MakeMagazinDE/Lora-Tuerueberwachung/Arduino_IDE_Boardeintrag ESP32-Board.png

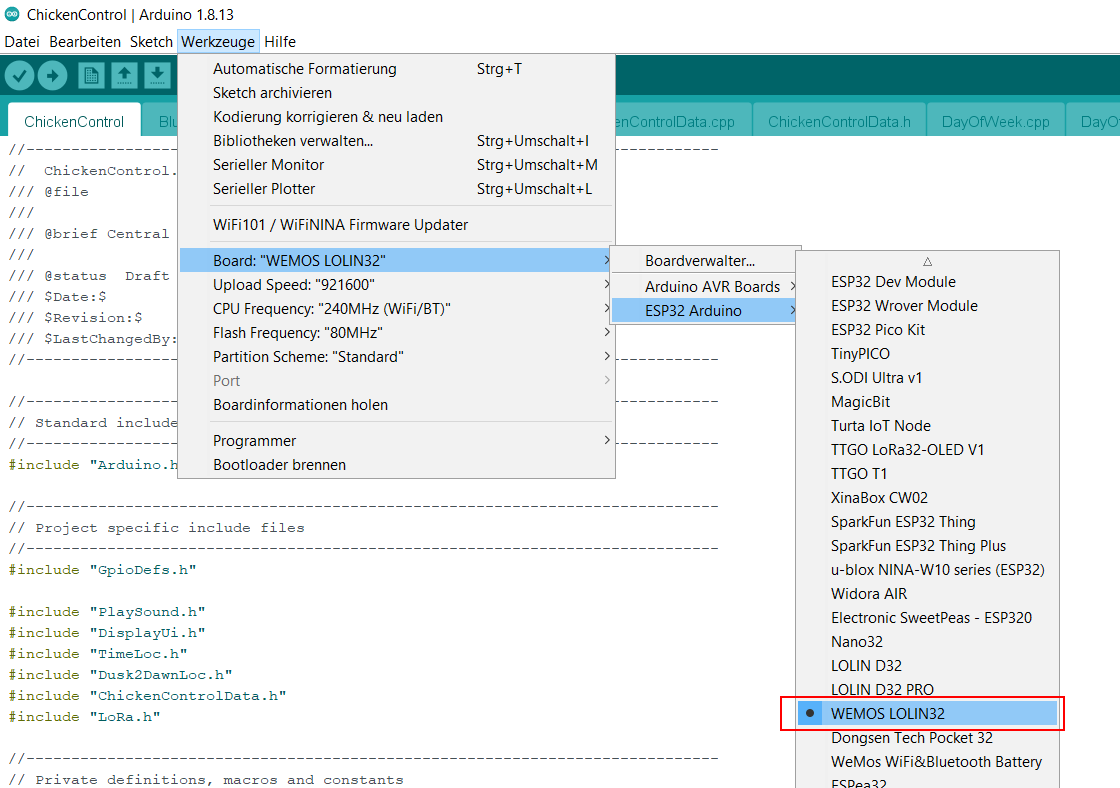
Arduino_IDE_Boardeintrag ESP32-Board.png
