MakeMagazinDE/Lora-Tuerueberwachung/Arduino_IDE_Library_Manager.png

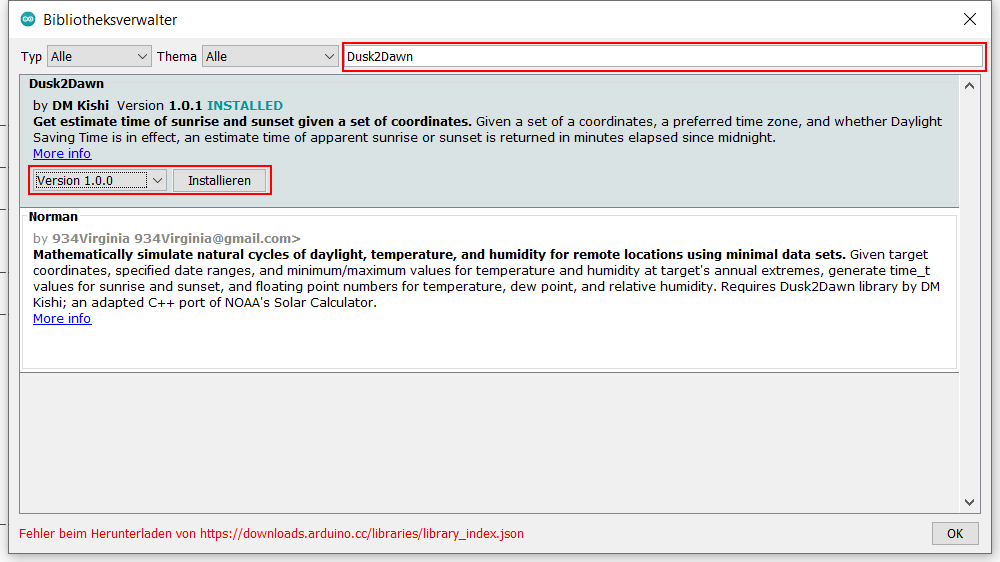
Arduino_IDE_Library_Manager.png
