MakeMagazinDE/Lora-Tuerueberwachung/Befestigung Ampmodul.png

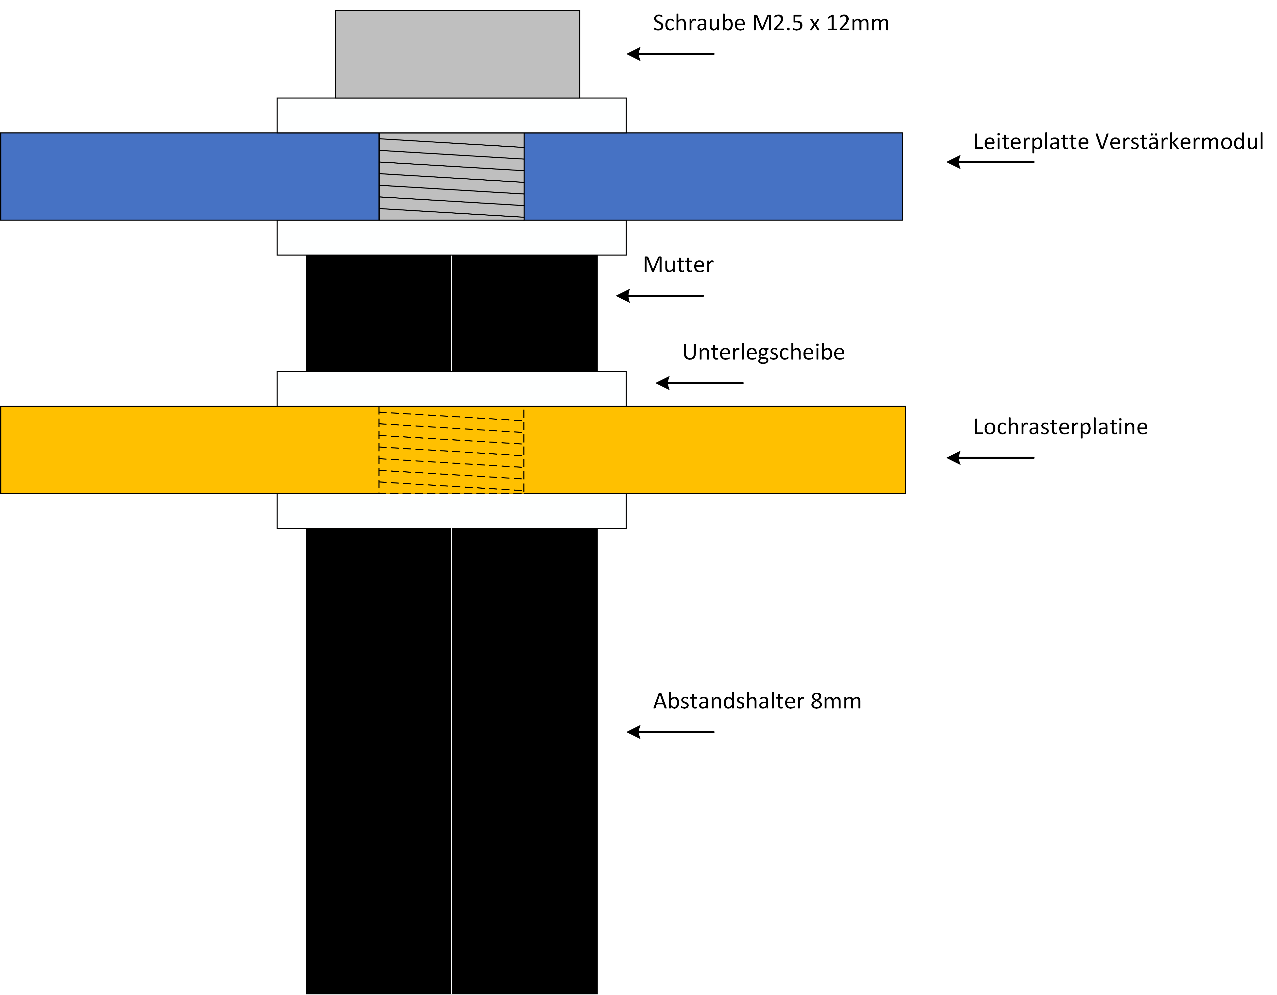
Befestigung Ampmodul.png
