MakeMagazinDE/Lora-Tuerueberwachung/ChickenControl Taskmodell.png

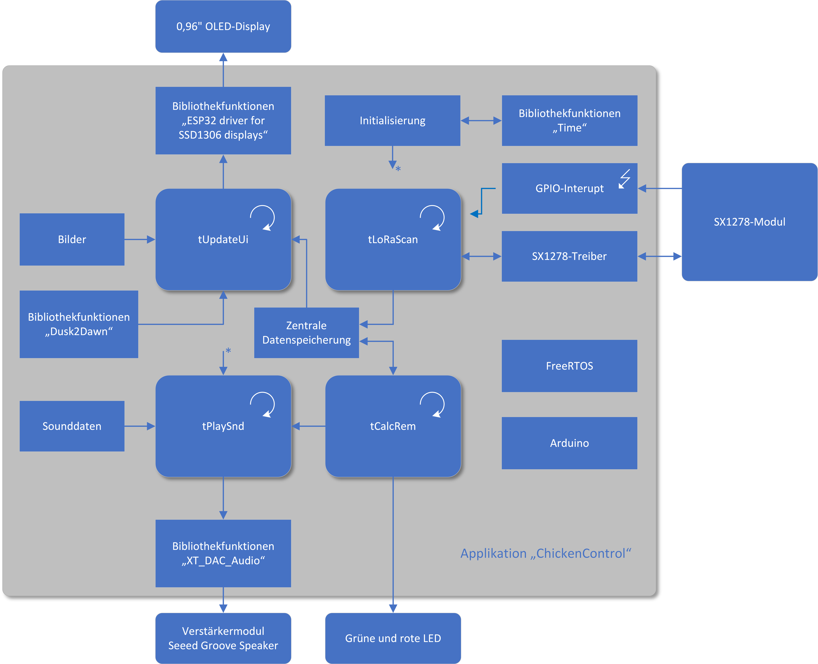
ChickenControl Taskmodell.png
