MakeMagazinDE/Lora-Tuerueberwachung/ChickenControl/DSCF0216_217_Combi.JPG

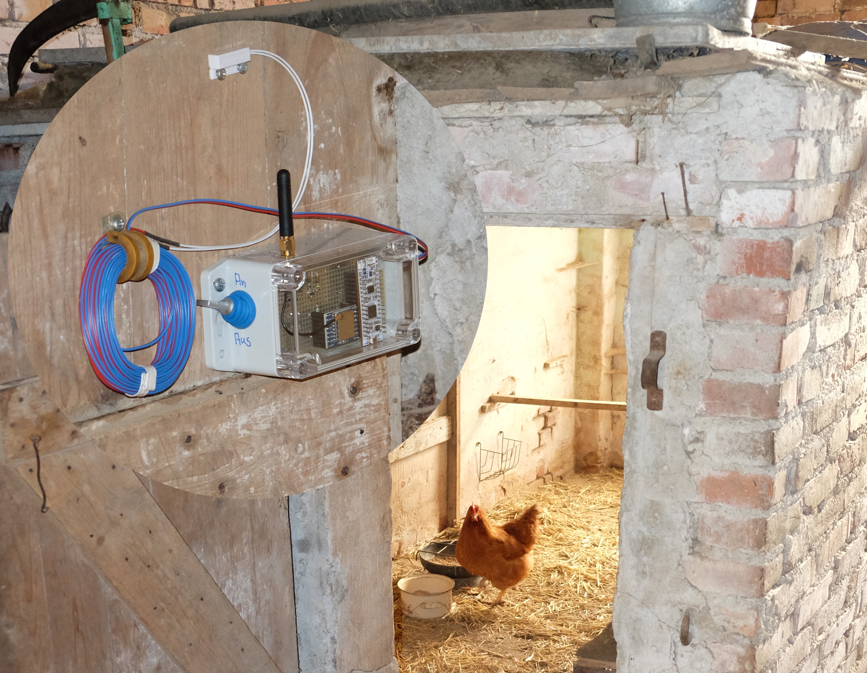
ChickenControl/DSCF0216_217_Combi.JPG
