MakeMagazinDE/Lora-Tuerueberwachung/ChickenControl_Ansicht_Oberseite.png

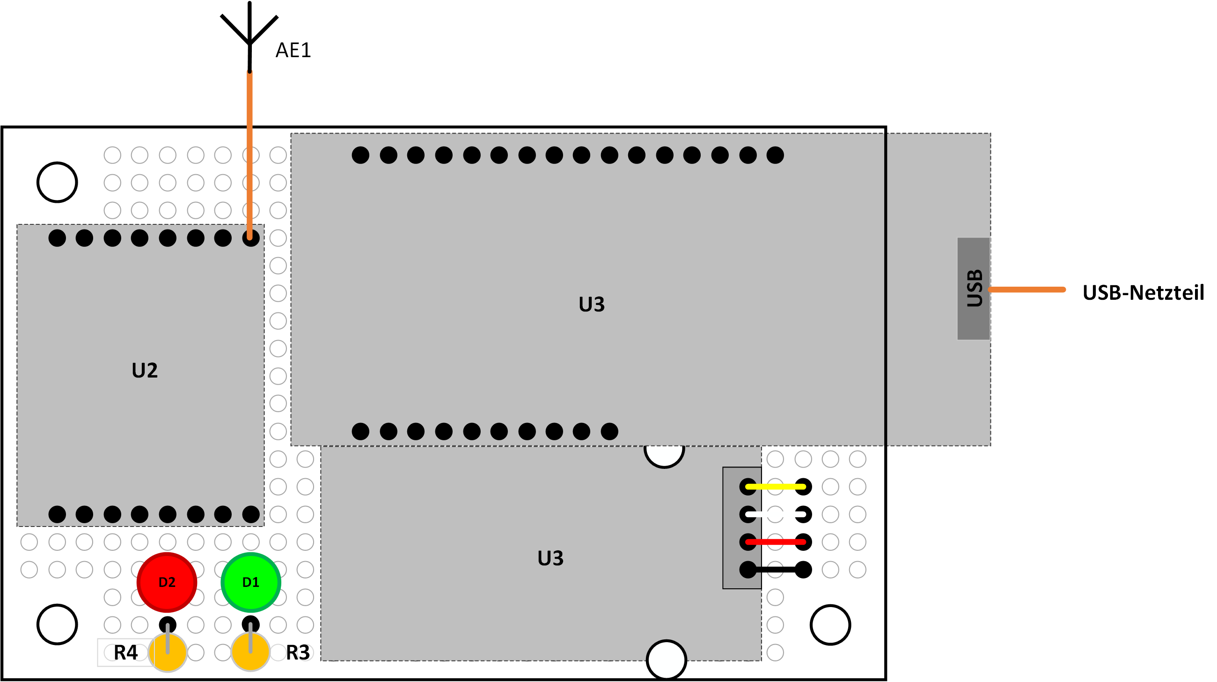
ChickenControl_Ansicht_Oberseite.png
