MakeMagazinDE/Lora-Tuerueberwachung/ChickenControl_Verdrahtung_einseitig.png

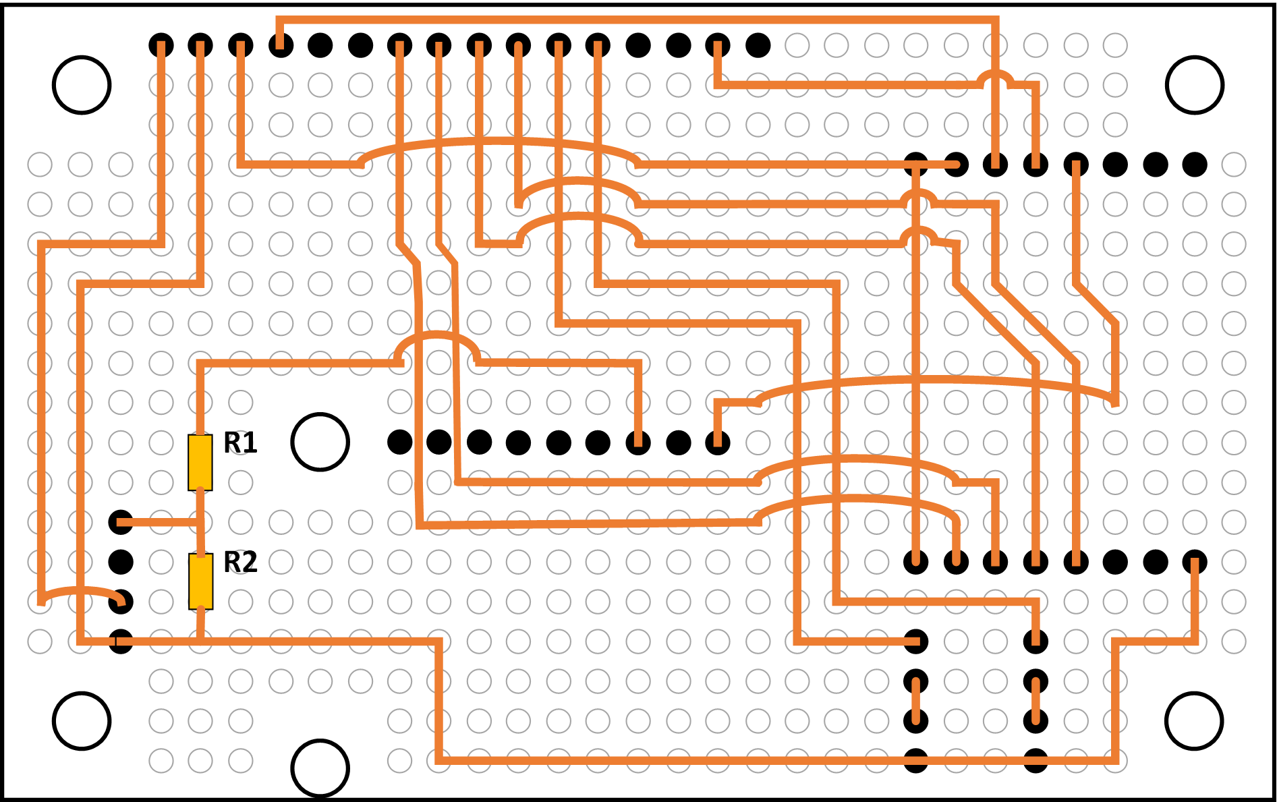
ChickenControl_Verdrahtung_einseitig.png
