MakeMagazinDE/Lora-Tuerueberwachung/ChickenControl_Verdrahtung_zweiseitig.png

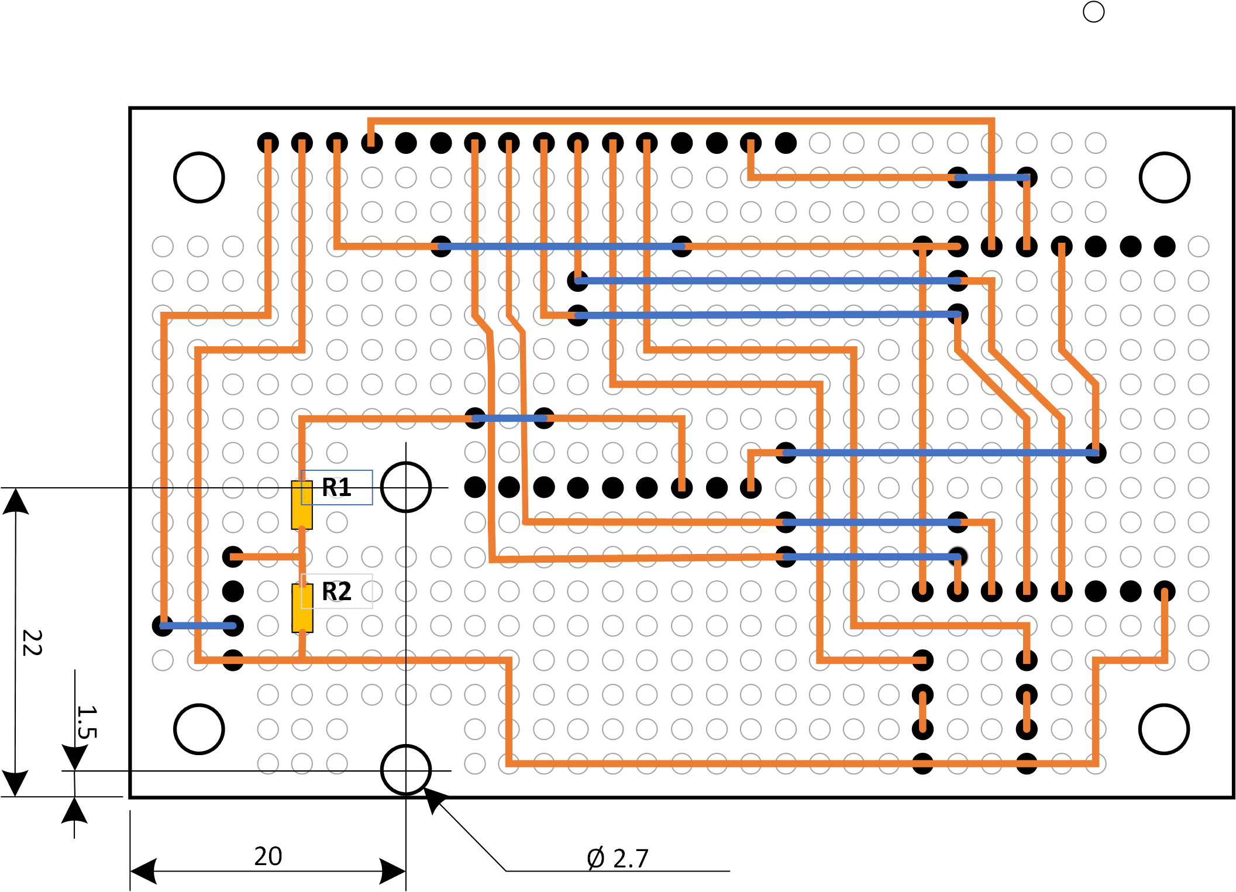
ChickenControl_Verdrahtung_zweiseitig.png
