MakeMagazinDE/Lora-Tuerueberwachung/ChickenHouse Ablaufplan.png

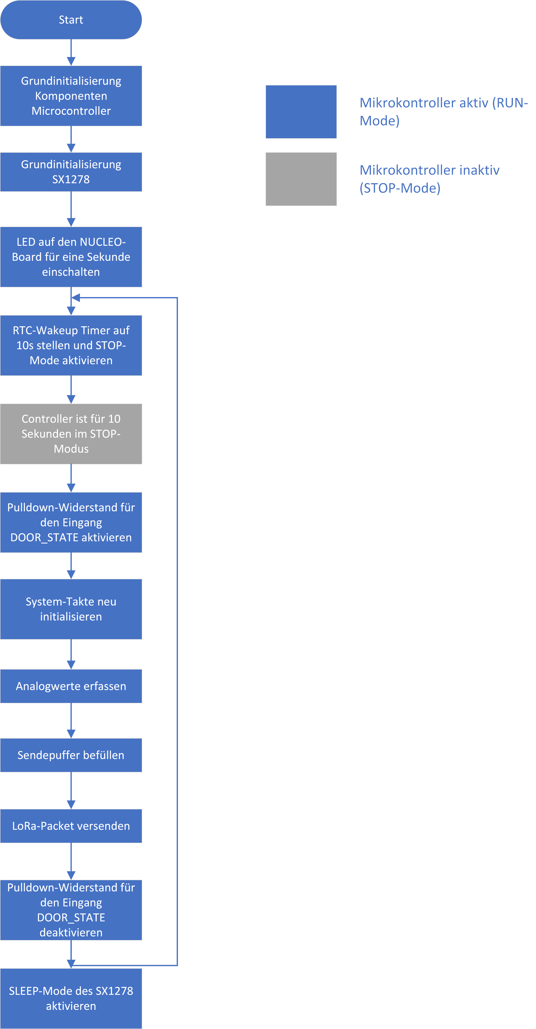
ChickenHouse Ablaufplan.png
