MakeMagazinDE/Lora-Tuerueberwachung/ChickenHouse_Leiterplatte_Oberseite_Alternativ.png

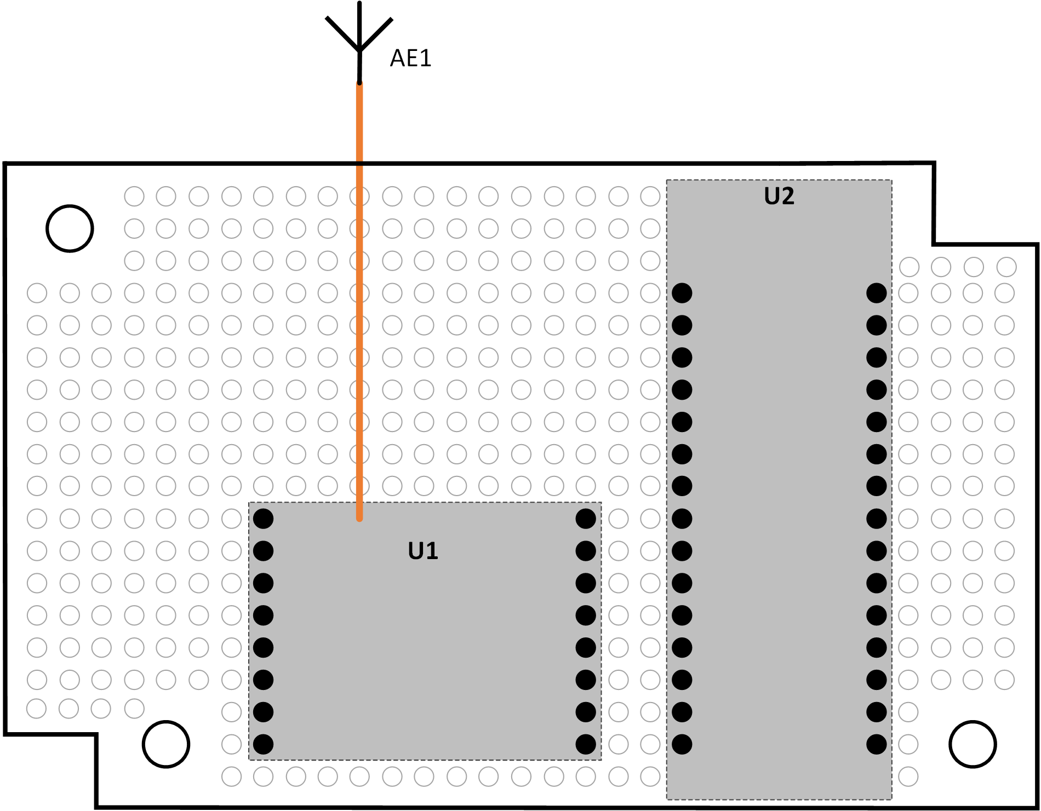
ChickenHouse_Leiterplatte_Oberseite_Alternativ.png
