MakeMagazinDE/Lora-Tuerueberwachung/ChickenHouse_Leiterplatte_Oberseite_fuellend.png

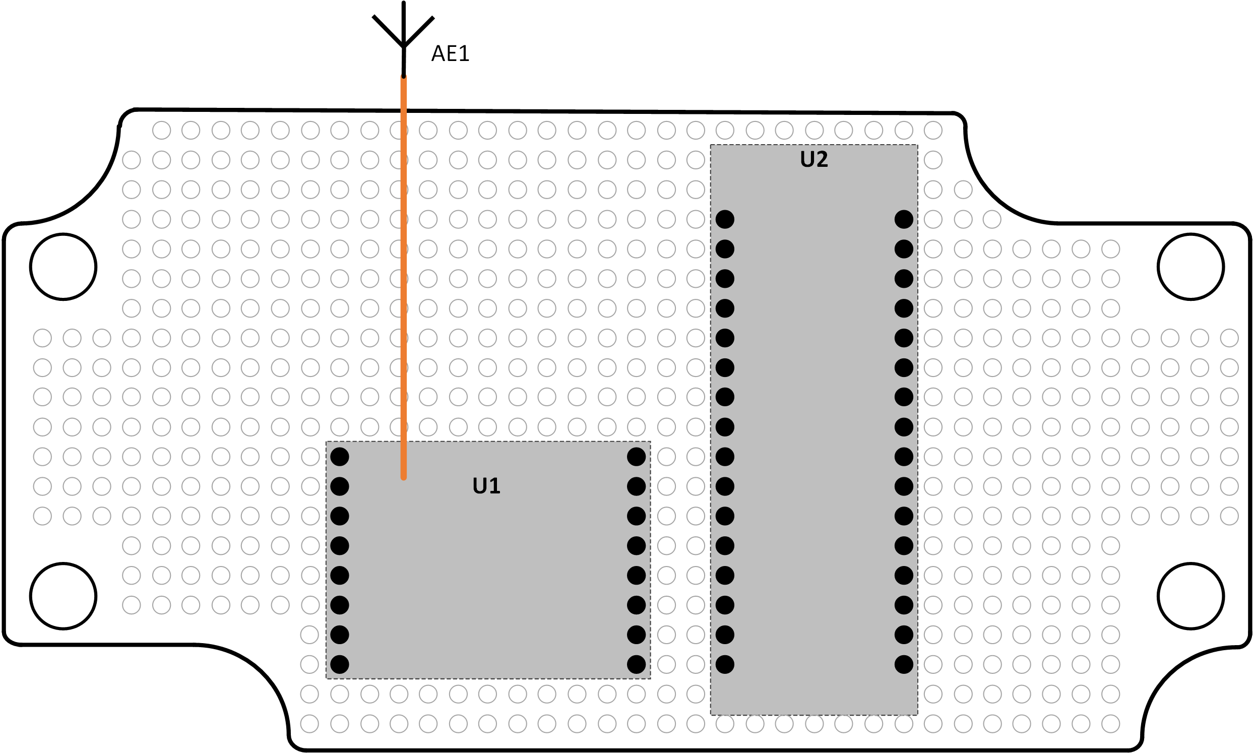
ChickenHouse_Leiterplatte_Oberseite_fuellend.png
