MakeMagazinDE/Lora-Tuerueberwachung/ChickenHouse_Leiterplatte_Unterseite_Alternativ.png

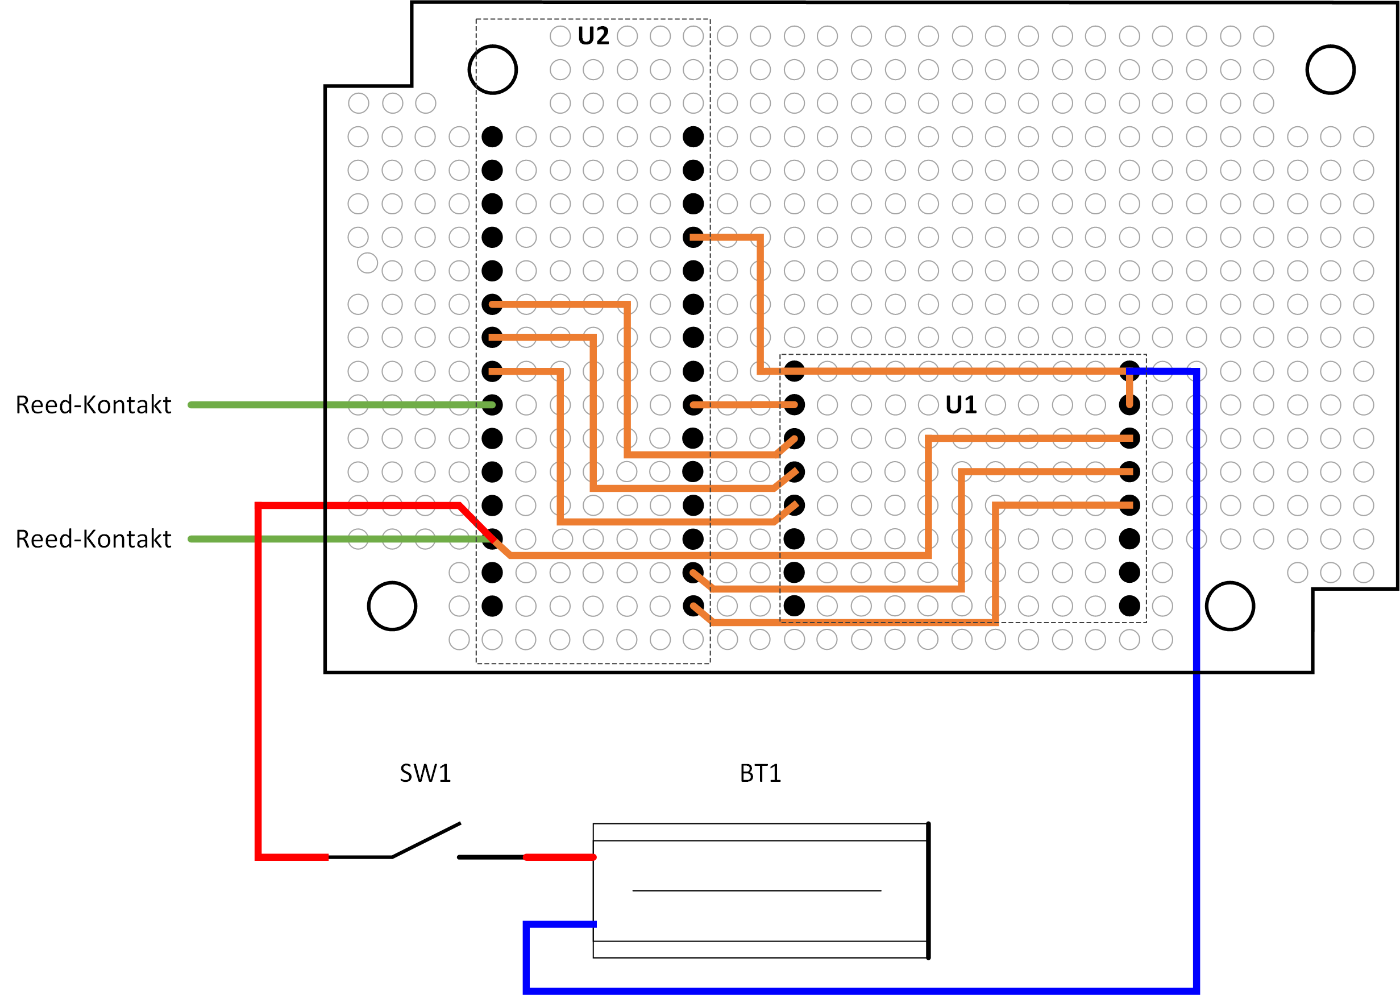
ChickenHouse_Leiterplatte_Unterseite_Alternativ.png
