MakeMagazinDE/Lora-Tuerueberwachung/ChickenHouse_Leiterplatte_Unterseite_fuellend.png

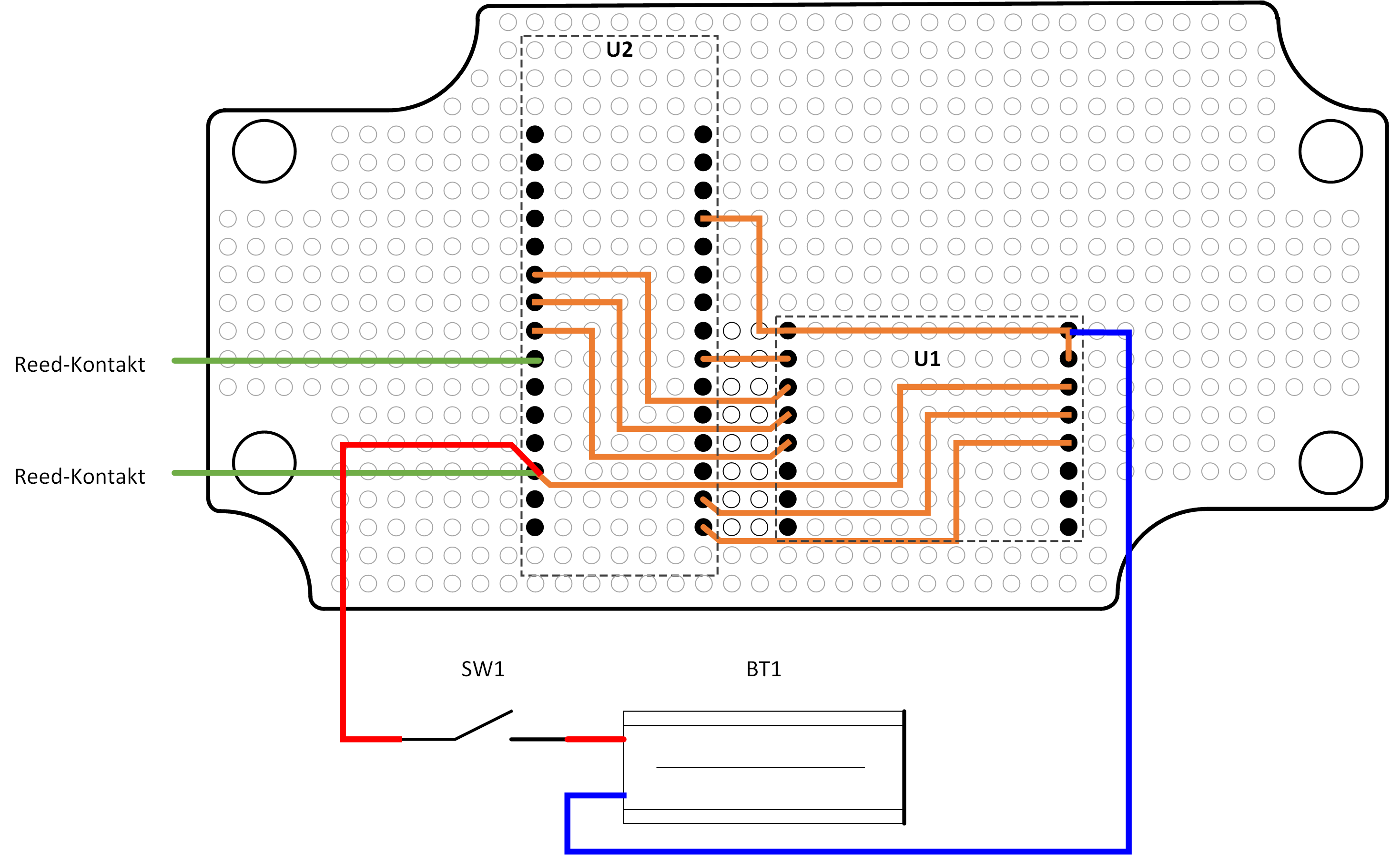
ChickenHouse_Leiterplatte_Unterseite_fuellend.png
