MakeMagazinDE/Lora-Tuerueberwachung/Configuration NUCLEO-Board L031.png

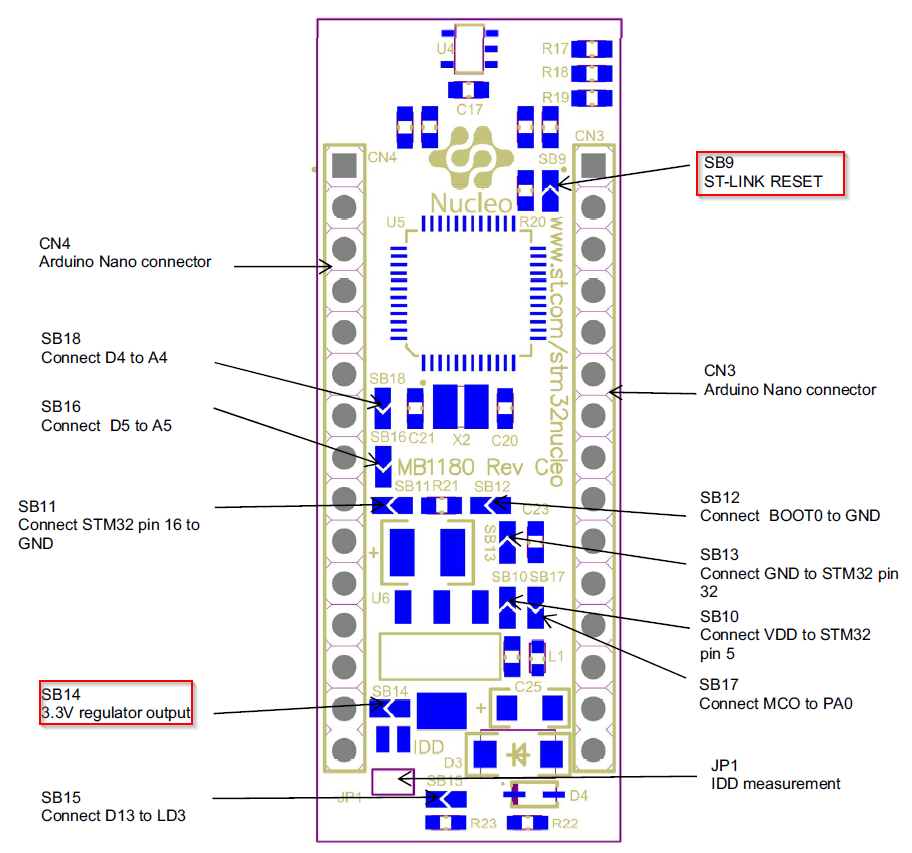
Configuration NUCLEO-Board L031.png
