MakeMagazinDE/Lora-Tuerueberwachung/DSCF0449.png

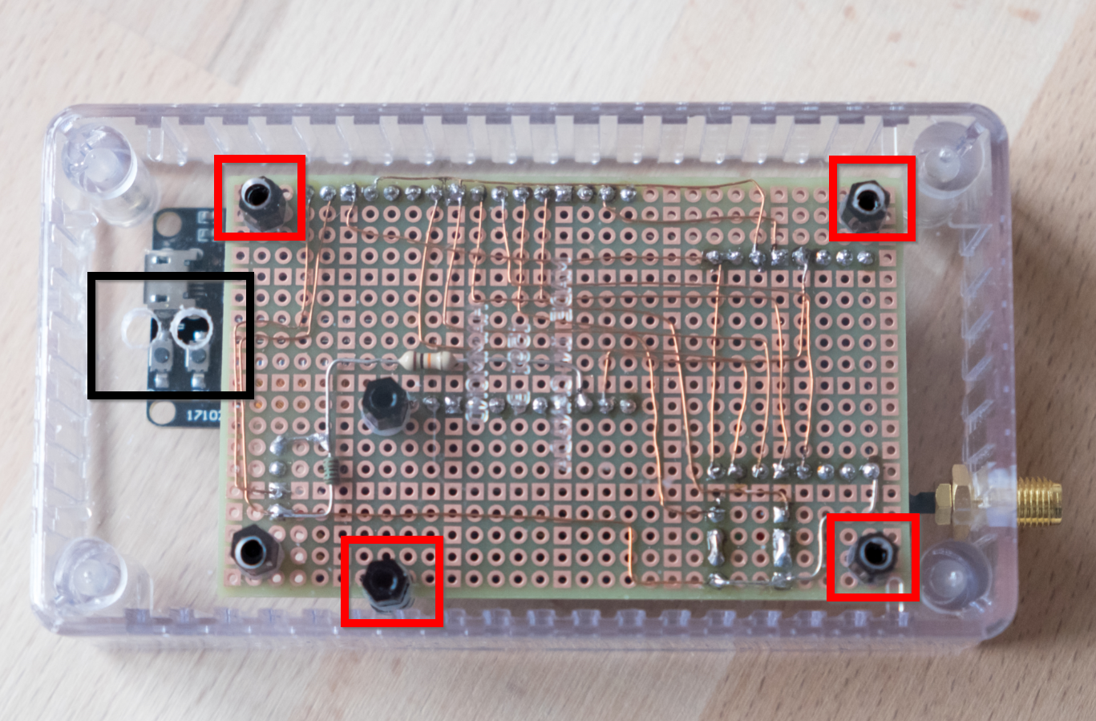
DSCF0449.png
