MakeMagazinDE/Lora-Tuerueberwachung/DSCF0459.JPG

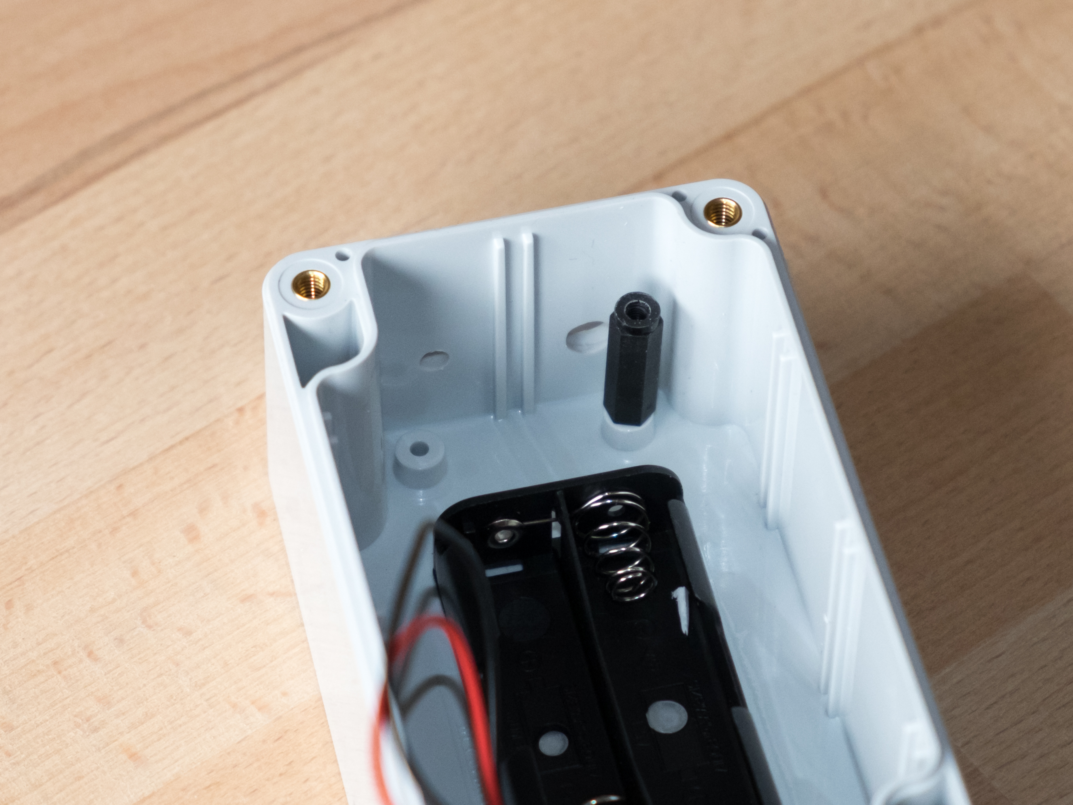
DSCF0459.JPG
