MakeMagazinDE/Lora-Tuerueberwachung/LoRaPacket.png

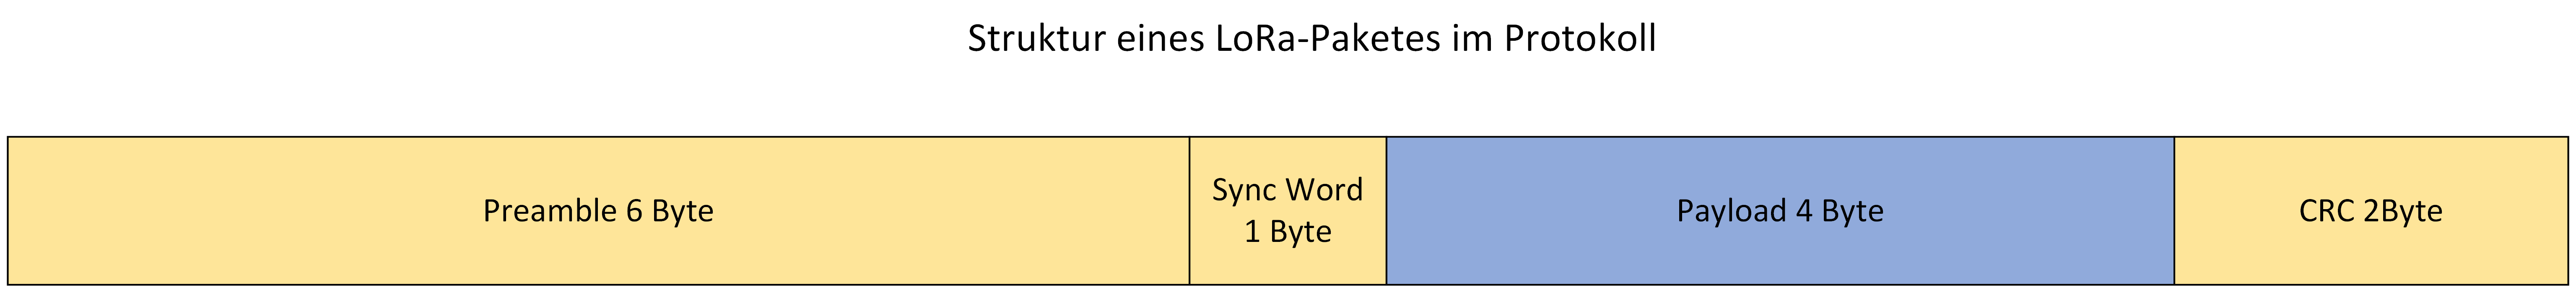
LoRaPacket.png
