MakeMagazinDE/Lora-Tuerueberwachung/Pinbelegung des Controller STM32L031.png

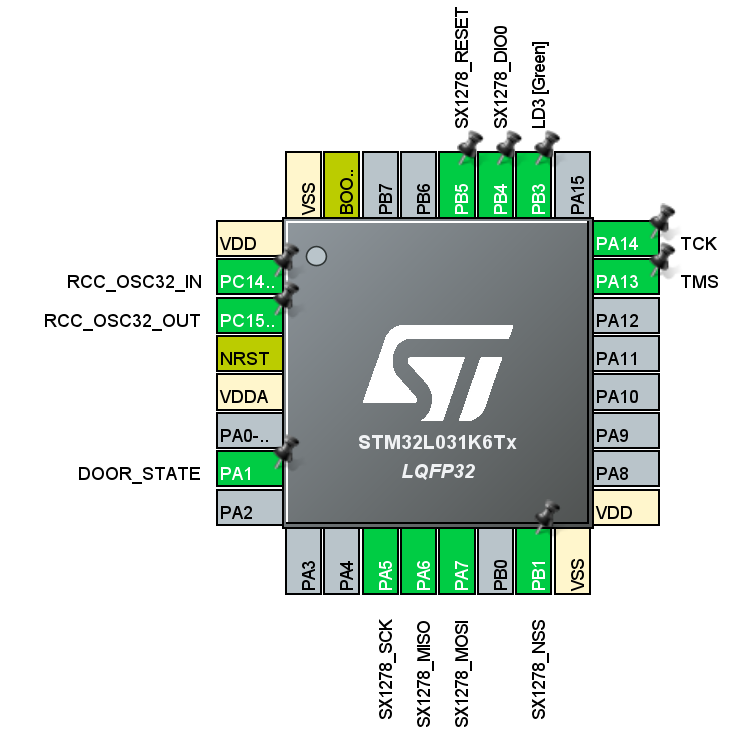
Pinbelegung des Controller STM32L031.png
