MakeMagazinDE/Lora-Tuerueberwachung/plan_empfänger.png

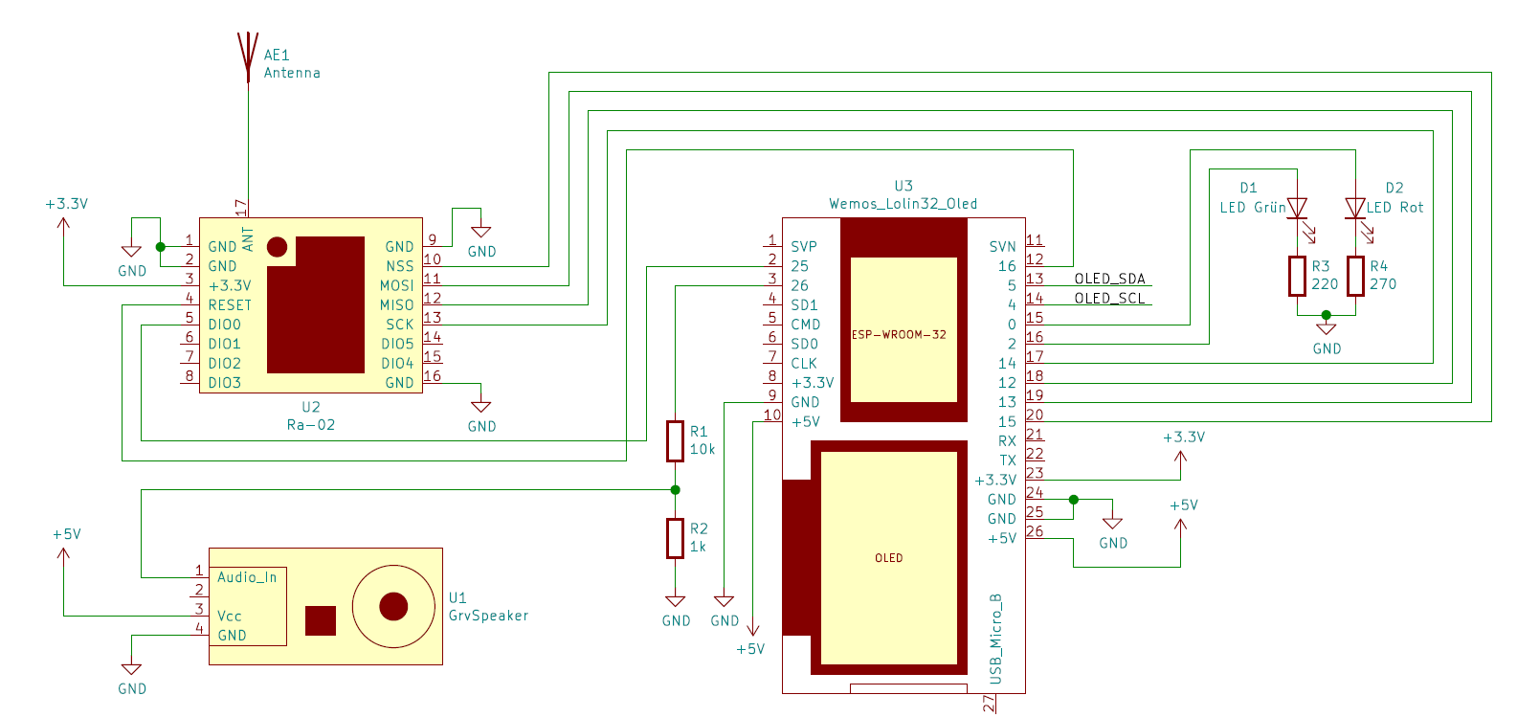
plan_empfänger.png
