MakeMagazinDE/Lora-Tuerueberwachung/plan_sender.png

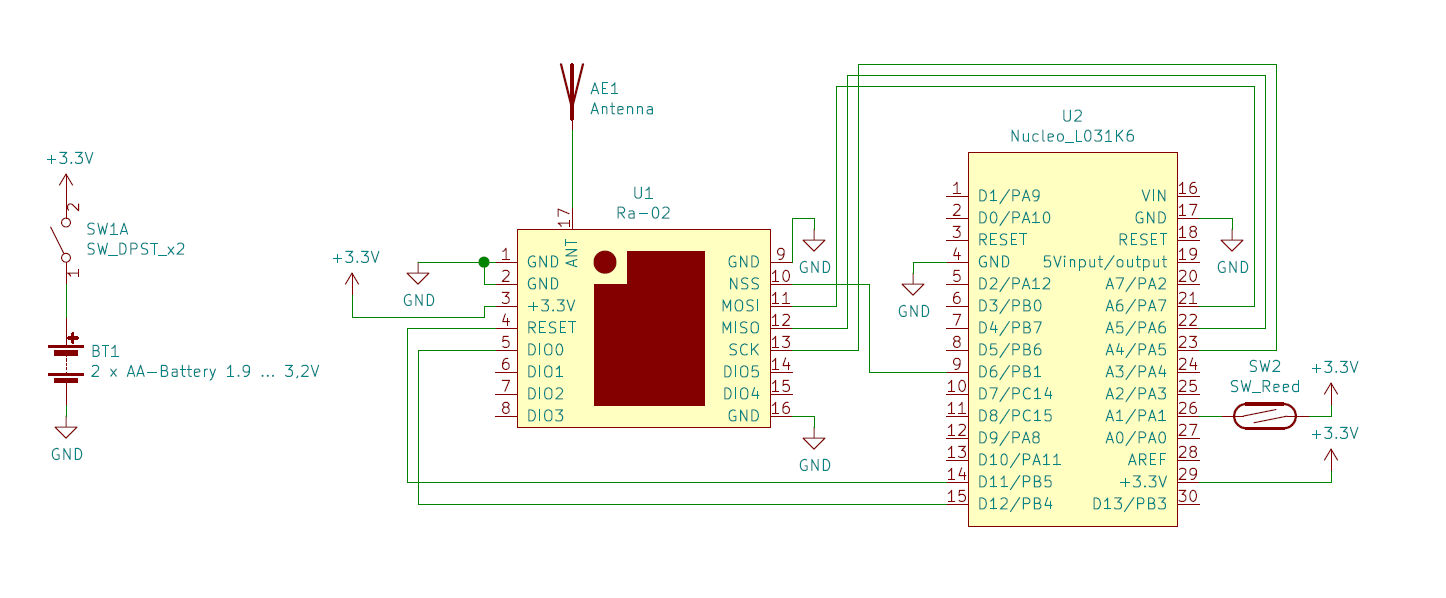
plan_sender.png
