MakeMagazinDE/Lora-Tuerueberwachung/Schaltung_Taster_neu.png

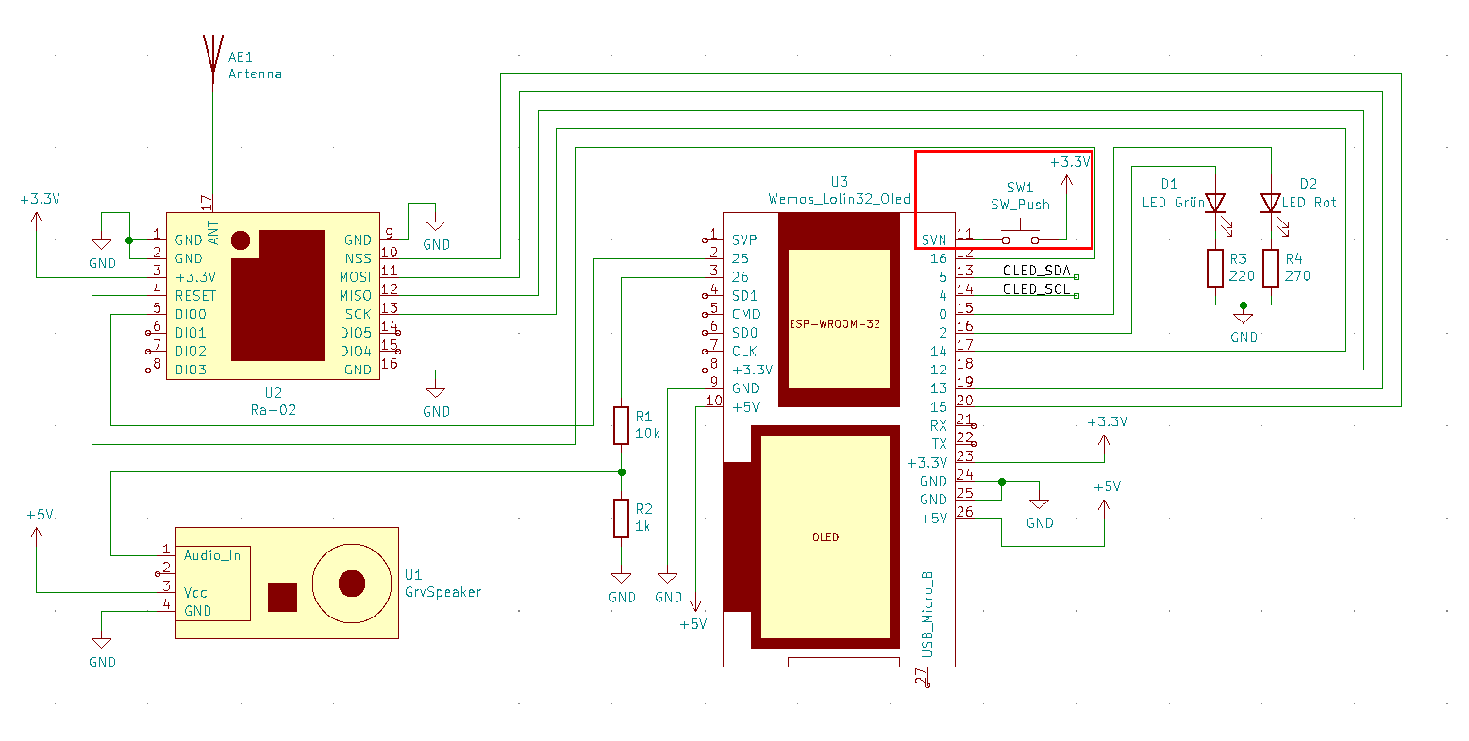
Schaltung_Taster_neu.png
