MakeMagazinDE/Lora-Tuerueberwachung/STM32_ST_Link_Utility_Programming.png

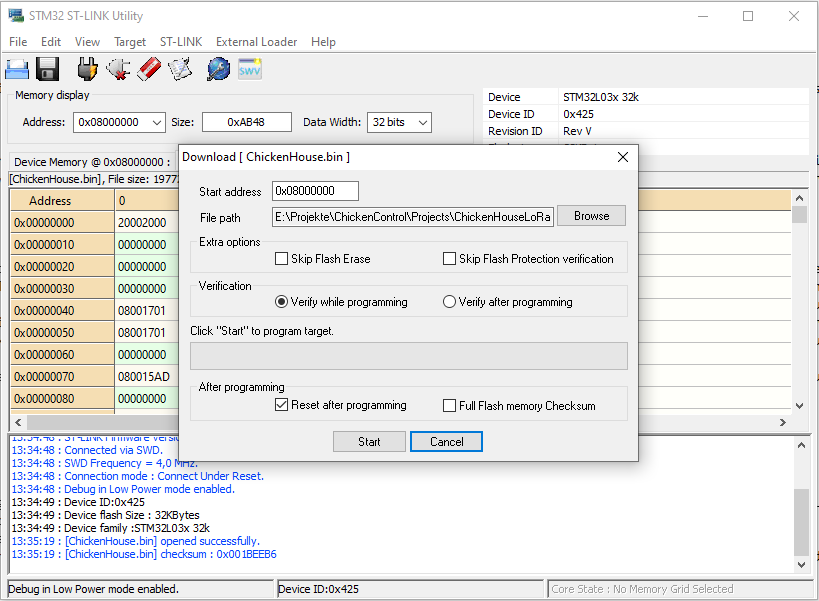
STM32_ST_Link_Utility_Programming.png
