MakeMagazinDE/Lora-Tuerueberwachung/ChickenControl Software Ablauf Setup.png

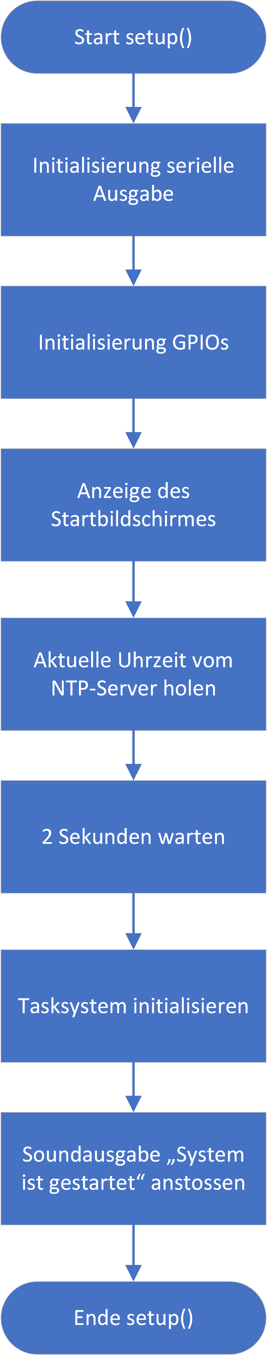
ChickenControl Software Ablauf Setup.png
