MakeMagazinDE/Lora-Tuerueberwachung/Systemaufbau.png

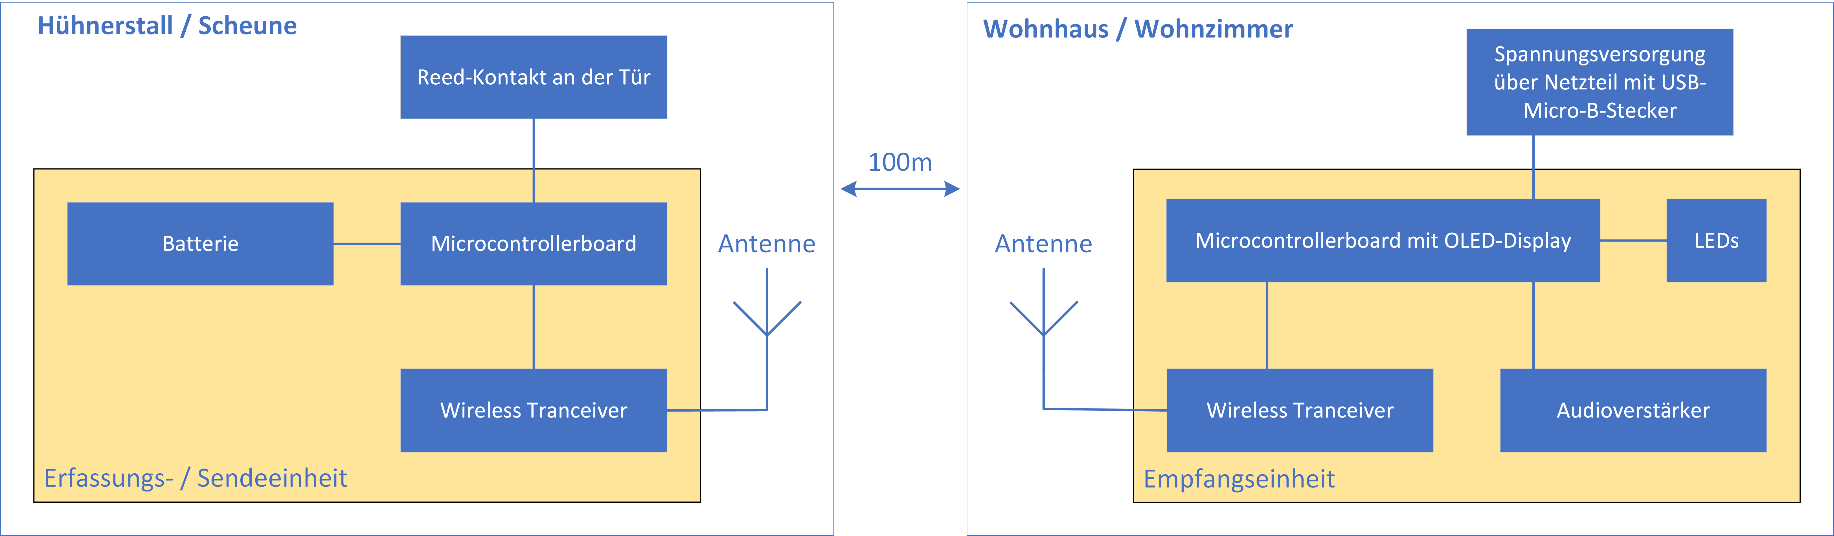
Systemaufbau.png
