MakeMagazinDE/Lora-Tuerueberwachung/ChickenHouseWoNucleo.pdf

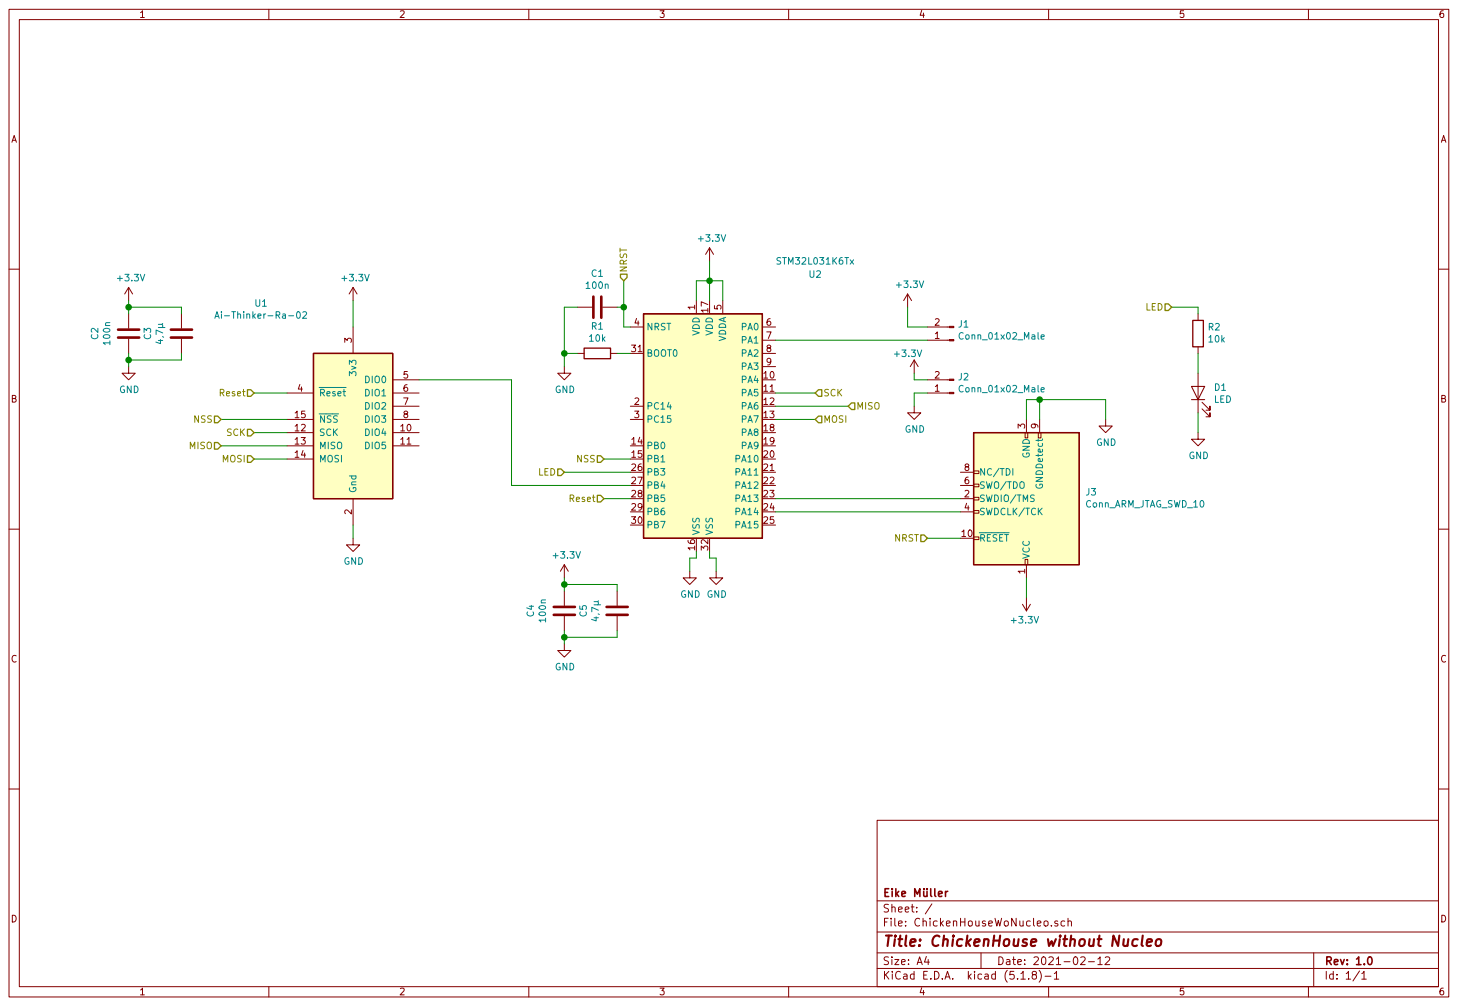
[picture p26: page 1]

3 Reset 4 DIO0 5 DIO1 6 DIO2 7 DIO3 8 U1 Ai-Thinker-Ra-02 GND VDD

1 PA4 10 PA5 11 PA6 12 PA7 13 PB0 14 PB1 15 VSS 16 VDD 17 PA8 18 PA9 19 PC14 2 PA10 20 PA11 21 PA12 22 PA13 23 PA14 24 PA15 25 PB3 26 PB4 27 PB5 28 PB6 29 PC15 3 PB7 30 BOOT0 31 VSS 32 NRST 4 VDDA

3 SWDCLK/TCK 4 SWO/TDO 6 NC/TDI 8 GNDDetect 9

1 RESET 10 SWDIO/TMS 2 GND

File: ChickenHouseWoNucleo.sch Sheet: / Eike Müller

Id: 1/1 Title: ChickenHouse without Nucleo
