MakeMagazinDE/Lora-Tuerueberwachung/Schaltplan ChickenHouse.pdf

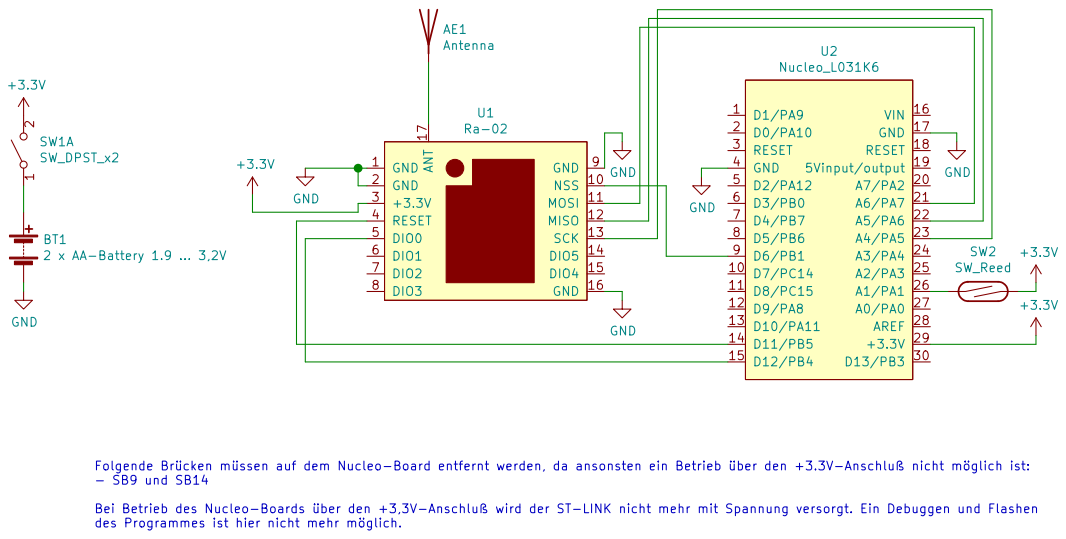
[picture p27: page 1]

Folgende Brücken müssen auf dem Nucleo-Board entfernt werden, da ansonsten ein Betrieb über den +3.3V-Anschluß nicht möglich ist: - SB9 und SB14 Bei Betrieb des Nucleo-Boards über den +3,3V-Anschluß wird der ST-LINK nicht mehr mit Spannung versorgt. Ein Debuggen und Flashen

des Programmes ist hier nicht mehr möglich.
