MakeMagazinDE/Lora-Tuerueberwachung/Schaltplan ChickenControl.pdf

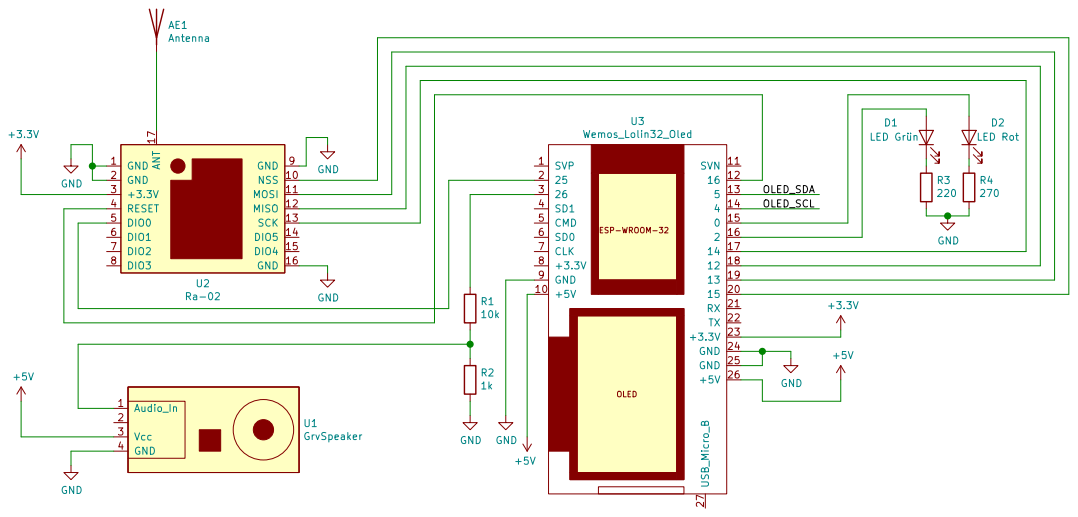
[picture p28: page 1]

Id: 1/1 Title: Chicken Control File: ChickenControl.sch Sheet: / Eike Müller
