MakeMagazinDE/Lora-Tuerueberwachung/ChickenDoor/Core/Inc/main.h

#define DOOR_STATE_Pin GPIO_PIN_1
#define DOOR_STATE_GPIO_Port GPIOA
#define SX1278_SCK_Pin GPIO_PIN_5
#define SX1278_SCK_GPIO_Port GPIOA
#define SX1278_MISO_Pin GPIO_PIN_6
#define SX1278_MISO_GPIO_Port GPIOA
#define SX1278_MOSI_Pin GPIO_PIN_7
#define SX1278_MOSI_GPIO_Port GPIOA
#define SX1278_NSS_Pin GPIO_PIN_1
#define SX1278_NSS_GPIO_Port GPIOB
#define TMS_Pin GPIO_PIN_13
#define TMS_GPIO_Port GPIOA
#define TCK_Pin GPIO_PIN_14
#define TCK_GPIO_Port GPIOA
#define LD3_Pin GPIO_PIN_3
#define LD3_GPIO_Port GPIOB
#define SX1278_DIO0_Pin GPIO_PIN_4
#define SX1278_DIO0_GPIO_Port GPIOB
#define SX1278_RESET_Pin GPIO_PIN_5
#define SX1278_RESET_GPIO_Port GPIOB
