MakeMagazinDE/Lora-Tuerueberwachung/ChickenDoor/Core/Src/main.c

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
/* Includes ------------------------------------------------------------------*/
#include "main.h"

/* USER CODE BEGIN Includes */
#include "SX1278.h"
#include "hal_time.h"
/* USER CODE END Includes */

/* USER CODE BEGIN PD */
/// Read analog digital converter values every 10 minutes
#define COUNTS_ADC_READ_INTERVAL          30
/// Standard check interval for the digital input (chicken house door)
#define MEASURING_INTERVAL_MS             20000

/// Temperature sensor calibration value address for 130 °C
#define TEMP130_CAL_ADDR                  ((uint16_t*) ((uint32_t) 0x1FF8007E))
/// Temperature sensor calibration value address for 30 °C
#define TEMP30_CAL_ADDR                   ((uint16_t*) ((uint32_t) 0x1FF8007A))
/// Vdd calibration voltage in unit mV
#define VDD_CALIB                         ((uint16_t) (3000))
/* USER CODE END PD */

ADC_HandleTypeDef hadc;
DMA_HandleTypeDef hdma_adc;

RTC_HandleTypeDef hrtc;

SPI_HandleTypeDef hspi1;

/* USER CODE BEGIN PV */
// Hardware connection for the SX1278 (DIO, Reset and Spi)
SX1278_hw_t SX1278_hw;
// Handle to the SX1278 driver
SX1278_t SX1278;

// Send buffer
uint8_t buffer[64];
// Length of a message
int message_length;

// Last computes temperature value
int8_t temperature;
// Last calculates reference voltage value
uint16_t batteryVoltage;

// Read counter for the digital analog converter
uint16_t counterReadAdc = 0xFFFF;

// Flag ad-conversion is complete
uint8_t ADC_ConversionComplete;
/* USER CODE END PV */

void SystemClock_Config(void);
static void MX_GPIO_Init(void);
static void MX_DMA_Init(void);
static void MX_RTC_Init(void);
static void MX_SPI1_Init(void);
static void MX_ADC_Init(void);
/* USER CODE BEGIN 0 */
//-----------------------------------------------------------------
// Function for low power mode
//-----------------------------------------------------------------
// Choose the low power mode to enter
static void EnterLowPowerMode(void);
// Setup for the low power mode
static void SetupLowPowerMode(bool enableFastWakeup);
// Performs all necessary things after wake up to get a working system
static void ResumeLowPowerMode(void);

//-----------------------------------------------------------------
// Function for analog digital converter
//-----------------------------------------------------------------
// Starts the adc-calibration
static void AdcCalibration(void);
// Gets the analog values via dma process
static void GetAnalogValues(void);
// Starts analog digital converting process if necessary
static void GetAnalogValuesIfNecesssary(void);
// Computes the temperature value
static int32_t ComputeTemperature(uint16_t measure, uint16_t vdda);
// Calculates the current value of the reference voltage (battery voltage) in unit mV
static uint16_t CalcVref3_3V(uint32_t adcValue);

//-----------------------------------------------------------------
// LoRa-Functions
//-----------------------------------------------------------------
// Initializes the SX1278 module
static void InitializeSX1278Module(void);
// Fills the send buffer for a LoRa-packet
static int FillSendBuffer(void);
// Sends out a LoRa-packet
static void SendLoRaPacket(uint8_t *txBuf, uint8_t length);

//-----------------------------------------------------------------
// Other Functions
//-----------------------------------------------------------------
// Gets the current state of the door input pin
static uint8_t GetDoorState(void);
// Enables the door input pin pull down resistor
static void EnableDoorStatePinPullDown(void);
// Disables the door input pin pull down resistor
static void DisableDoorStatePinPullDown(void);
// Shows the led at start for one second
static void ShowLedAtStart(void);
// Generates an 8-Bit-Crc for a stream
uint8_t GenerateCrc(uint8_t *data, size_t len);
/* USER CODE END 0 */

/**
  * @brief  The application entry point.
  * @retval int
  */
int main(void)
{
   /* MCU Configuration--------------------------------------------------------*/

   /* Reset of all peripherals, Initializes the Flash interface and the Systick. */
   HAL_Init();

   /* Configure the system clock */
   SystemClock_Config();

   /* Initialize all configured peripherals */
   MX_GPIO_Init();
   MX_DMA_Init();
   MX_RTC_Init();
   MX_SPI1_Init();
   MX_ADC_Init();
   /* USER CODE BEGIN 2 */

   AdcCalibration();

   InitializeSX1278Module();

   ShowLedAtStart();
   /* USER CODE END 2 */

   /* Infinite loop */
   /* USER CODE BEGIN WHILE */
   while (1)
   {
      EnterLowPowerMode();

      EnableDoorStatePinPullDown();

      ResumeLowPowerMode();

      GetAnalogValuesIfNecesssary();

      message_length = FillSendBuffer();

      SendLoRaPacket((uint8_t *) buffer, message_length);

      DisableDoorStatePinPullDown();

      SX1278_sleep(&SX1278);
      /* USER CODE END WHILE */

      /* USER CODE BEGIN 3 */
   }
   /* USER CODE END 3 */
}

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
/* USER CODE BEGIN 4 */

//-----------------------------------------------------------------
// Function for low power mode
//-----------------------------------------------------------------

/**
 * @brief Choose the low power mode to enter
 *
 * If we don't need reading the analog values after wake, fast wake up will be choose to reduce the power consumption
 */
static void EnterLowPowerMode(void)
{
   if (counterReadAdc == 0xFFFF || counterReadAdc == COUNTS_ADC_READ_INTERVAL)
   {
      SetupLowPowerMode(false);
   }
   else
   {
      SetupLowPowerMode(true);
   }
}

/**
 * @brief Setup for the low power mode
 *
 * @param enableFastWakeup: true - Fast wake up is enable (reference voltage not stable directly after wake up),
 *                          false - Fast wake up disabled (reference voltage is stable after wake up)
 */
static void SetupLowPowerMode(bool enableFastWakeup)
{
   // Configure RTC to wake up after 20000ms
   uint32_t _time = (((uint32_t)MEASURING_INTERVAL_MS) * 2314) / 1000;
   HAL_RTCEx_SetWakeUpTimer_IT(&hrtc, _time, RTC_WAKEUPCLOCK_RTCCLK_DIV16);

   // Enable Power Control clock
   __HAL_RCC_PWR_CLK_ENABLE();
   // Enable ultra low power mode
   HAL_PWREx_EnableUltraLowPower();

      if (true == enableFastWakeup)
      HAL_PWREx_EnableFastWakeUp();    // Fast wake-up for ultra low power mode
   else
      HAL_PWREx_DisableFastWakeUp();   // Fast wake-up for ultra low power mode

   // Switch to STOP-Mode
   HAL_PWR_EnterSTOPMode(PWR_LOWPOWERREGULATOR_ON, PWR_STOPENTRY_WFI);
}

/**
 * Performs all necessary things after wake up to get a working system
 */
static void ResumeLowPowerMode(void)
{
   // Reinitializes clocks
   SystemClock_Config();
}

//-----------------------------------------------------------------
// Function for analog digital converter
//-----------------------------------------------------------------

/**
 * Gets the analog values via dma process
 */
static void GetAnalogValues(void)
{
   uint16_t regularItems[2];

   ADC_ConversionComplete = 0;

   // start dma process and ...
   if (HAL_ADC_Start_DMA(&hadc, (uint32_t *)regularItems, 2) != HAL_OK)
   {
      Error_Handler();
   }

   // ... wait for the end of DMA transfer ...
   while ( 0 == ADC_ConversionComplete )
   {
   }

   // ... stop the dma
   HAL_ADC_Stop_DMA(&hadc);

   // calculate the values
   batteryVoltage = CalcVref3_3V(regularItems[0]);

   temperature = ComputeTemperature(regularItems[1], batteryVoltage);
}

/**
 * Starts analog digital converting process if necessary
 */
static void GetAnalogValuesIfNecesssary(void)
{
   if (counterReadAdc == 0xFFFF || counterReadAdc == COUNTS_ADC_READ_INTERVAL)
   {
      GetAnalogValues();
      counterReadAdc = 0;
   }
   else
   {
      counterReadAdc++;
   }
}

/**
 * @brief Computes the temperature value
 *
 * @param measure: Raw measuring value
 * @param vdda: Current voltage value of the battery (unit mV)
 *
 * @retval Temperature value in degree celcius
 */
static int32_t ComputeTemperature(uint16_t measure, uint16_t vdda)
{
   int32_t temperatureValue;
   temperatureValue = ((measure * vdda / VDD_CALIB) - (int32_t) *TEMP30_CAL_ADDR );

   temperatureValue = temperatureValue * (int32_t)(130 - 30);
   temperatureValue = temperatureValue / (int32_t)(*TEMP130_CAL_ADDR - *TEMP30_CAL_ADDR);
   temperatureValue = temperatureValue + 30;

   return (temperatureValue);
}

/**
 * @brief Calculates the current value of the reference voltage (battery voltage) in unit mV
 *
 * @param adcValue: Raw measuring value
 *
 * @retval Reference voltage (battery voltage) in unit mV
 */
static uint16_t CalcVref3_3V(uint32_t adcValue)
{
   uint16_t vrefint_cal = *((uint16_t*)0x1FF80078);

   uint16_t vdda = (uint16_t)((3000 * vrefint_cal) / adcValue);

   return vdda;
}

//-----------------------------------------------------------------
// LoRa-Functions
//-----------------------------------------------------------------

/**
 * Initializes the SX1278 module
 */
static void InitializeSX1278Module(void)
{
   // initialize hardware connection
   SX1278_hw.dio0.port = SX1278_DIO0_GPIO_Port;
   SX1278_hw.dio0.pin = SX1278_DIO0_Pin;
   SX1278_hw.nss.port = SX1278_NSS_GPIO_Port;
   SX1278_hw.nss.pin = SX1278_NSS_Pin;
   SX1278_hw.reset.port = SX1278_RESET_GPIO_Port;
   SX1278_hw.reset.pin = SX1278_RESET_Pin;
   SX1278_hw.spi = &hspi1;

   SX1278.hw = &SX1278_hw;

   // Initialize the SX1278 module
   // - Frequency: 433 MHz
   // - Send power: 14 dbm
   // - LoRa rate: 6 (spreading factor)
   // - Bandwidth: 250kHz
   // - Packet length: 10 bytes
   SX1278_begin(&SX1278, SX1278_433MHZ, SX1278_POWER_17DBM, SX1278_LORA_SF_10, SX1278_LORA_BW_250KHZ, 10, SX1278_LORA_IMPLICIT_HEADER_MODE);
}

/**
 * Fills the send buffer for a LoRa-packet
 *
 * @retval Length of the send buffer
 */
static int FillSendBuffer(void)
{
   buffer[0] = GetDoorState();
   buffer[1] = (uint8_t)temperature;
   buffer[2] = (uint8_t)((batteryVoltage >> 8) & 0xFF);
   buffer[3] = (uint8_t)(batteryVoltage & 0xFF);
   buffer[4] = GenerateCrc(buffer, 4);

   return 5;
}

/**
 * Generates an 8-Bit-Crc for a stream
 *
 * @param data: Pointer to the data stream
 * qparam len: Length of the data stream
 *
 * @retval Calculated crc
 */
uint8_t GenerateCrc(uint8_t *data, size_t len)
{
   uint8_t crc = 0xff;
   size_t i, j;

   for (i = 0; i < len; i++)
   {
      crc ^= data[i];

      for (j = 0; j < 8; j++)
      {
         if ((crc & 0x80) != 0)
            crc = (uint8_t)((crc << 1) ^ 0x31);
         else
            crc <<= 1;
      }
   }

   return crc;
}


/**
 * Sends out a LoRa-packet
 *
 * @param txBuf: Buffer with data to send
 * @param length: Length of the send buffer in bytes
 */
static void SendLoRaPacket(uint8_t *txBuf, uint8_t length)
{
   SX1278_LoRaEntryTx(&SX1278, length, 2000);

   SX1278_LoRaTxPacket(&SX1278, txBuf, length, 2000);
}

//-----------------------------------------------------------------
// Other Functions
//-----------------------------------------------------------------

/**
 * @brief Gets the current state of the door input pin
 *
 * @retval Current state of the door input pin (0 - Door closed, 1 - Door open)
 */
static uint8_t GetDoorState(void)
{
   char retVal;

   if (HAL_GPIO_ReadPin(DOOR_STATE_GPIO_Port, DOOR_STATE_Pin) == GPIO_PIN_SET)
   {
      retVal = 0x01;
   }
   else
   {
      retVal = 0x00;
   }

   return retVal;
}

/**
 * Enables the door input pin pull down resistor
 */
void EnableDoorStatePinPullDown(void)
{
   GPIO_InitTypeDef GPIO_InitStruct = {0};

   /*Configure GPIO pin : DOOR_STATE_Pin */
   GPIO_InitStruct.Pin = DOOR_STATE_Pin;
   GPIO_InitStruct.Mode = GPIO_MODE_INPUT;
   GPIO_InitStruct.Pull = GPIO_PULLDOWN;
   HAL_GPIO_Init(DOOR_STATE_GPIO_Port, &GPIO_InitStruct);
}

/**
 * Disables the door input pin pull down resistor
 */
static void DisableDoorStatePinPullDown(void)
{
   GPIO_InitTypeDef GPIO_InitStruct = {0};

   /*Configure GPIO pin : DOOR_STATE_Pin */
   GPIO_InitStruct.Pin = DOOR_STATE_Pin;
   GPIO_InitStruct.Mode = GPIO_MODE_INPUT;
   GPIO_InitStruct.Pull = GPIO_NOPULL;
   HAL_GPIO_Init(DOOR_STATE_GPIO_Port, &GPIO_InitStruct);
}

/**
 * Starts the adc-calibration
 */
static void AdcCalibration(void)
{
   if (HAL_ADCEx_Calibration_Start(&hadc, ADC_SINGLE_ENDED) !=  HAL_OK)
   {
      Error_Handler();
   }
}

/**
 * Shows the led at start for one second
 */
static void ShowLedAtStart(void)
{
   HAL_GPIO_WritePin(LD3_GPIO_Port, LD3_Pin, GPIO_PIN_SET);

   HAL_Delay(1000);

   HAL_GPIO_WritePin(LD3_GPIO_Port, LD3_Pin, GPIO_PIN_RESET);
}


/* USER CODE END 4 */
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
