MakeMagazinDE/Lora-Tuerueberwachung/ChickenControl/DisplayCtrl.h

//-----------------------------------------------------------------------------
//  DisplayCtrl.h
/// @file
///
/// @brief Header for the module DisplayCtrl.cpp
///
/// $Date:$
/// $Revision:$
/// $LastChangedBy:$
///
//-----------------------------------------------------------------------------
#ifndef __DISPLAYCTRL_H
 #define __DISPLAYCTRL_H

//-----------------------------------------------------------------------------
// Standard include files
//-----------------------------------------------------------------------------

//-----------------------------------------------------------------------------
// Project specific include files
//-----------------------------------------------------------------------------

//-----------------------------------------------------------------------------
// Definitions ,macros and constants
//-----------------------------------------------------------------------------

//-----------------------------------------------------------------------------
// Datatypes
//-----------------------------------------------------------------------------

//-----------------------------------------------------------------------------
// Prototypes of public functions
//-----------------------------------------------------------------------------
// Task function of the display control task
void TaskDisplayCtrl (void * pvParameters);
// Initiates the 'Display on' state
void StartDisplayOn(void);

#endif //__DISPLAYCTRL_H
