MakeMagazinDE/Lora-Tuerueberwachung/ChickenControl/Dusk2DawnLoc.h

//-----------------------------------------------------------------------------
//  Dusk2DawnLoc.h
/// @file
///
/// @brief Header for the module Dusk2DawnLoc.cpp
///
/// $Date:$
/// $Revision:$
/// $LastChangedBy:$
///
//-----------------------------------------------------------------------------
#ifndef __DUSK2DAWNLOC_H
 #define __DUSK2DAWNLOC_H

//-----------------------------------------------------------------------------
// Standard include files
//-----------------------------------------------------------------------------

//-----------------------------------------------------------------------------
// Project specific include files
//-----------------------------------------------------------------------------

//-----------------------------------------------------------------------------
// Definitions ,macros and constants
//-----------------------------------------------------------------------------

//-----------------------------------------------------------------------------
// Data types
//-----------------------------------------------------------------------------

//-----------------------------------------------------------------------------
// Prototypes of public functions
//-----------------------------------------------------------------------------
// Gets the sunrise for today
int GetSunriseForToday(void);
// Gets the sunset for today
int GetSunsetForToday(void);

#endif //__DUSK2DAWNLOC_H
