MakeMagazinDE/Lora-Tuerueberwachung/ChickenControl/KeyCheck.h

//-----------------------------------------------------------------------------
//  KeyCheck.h
/// @file
///
/// @brief Header for the module KeyCheck.cpp
///
/// $Date:$
/// $Revision:$
/// $LastChangedBy:$
///
//-----------------------------------------------------------------------------
#ifndef __KEYCHECK_H
 #define __KEYCHECK_H

//-----------------------------------------------------------------------------
// Standard include files
//-----------------------------------------------------------------------------

//-----------------------------------------------------------------------------
// Project specific include files
//-----------------------------------------------------------------------------

//-----------------------------------------------------------------------------
// Definitions ,macros and constants
//-----------------------------------------------------------------------------

//-----------------------------------------------------------------------------
// Datatypes
//-----------------------------------------------------------------------------

//-----------------------------------------------------------------------------
// Prototypes of public functions
//-----------------------------------------------------------------------------
// Task function of the key check task
void TaskKeyCheck (void * pvParameters);

#endif //__KEYCHECK_H
