MakeMagazinDE/Lora-Tuerueberwachung/ChickenControl/LoRa.h

//-----------------------------------------------------------------------------
//  LoRa.h
/// @file
///
/// @brief Header for the module LoRa.cpp
///
/// $Date:$
/// $Revision:$
/// $LastChangedBy:$
///
//-----------------------------------------------------------------------------
#ifndef __LORA_H
 #define __LORA_H

//-----------------------------------------------------------------------------
// Standard include files
//-----------------------------------------------------------------------------

//-----------------------------------------------------------------------------
// Project specific include files
//-----------------------------------------------------------------------------

//-----------------------------------------------------------------------------
// Definitions ,macros and constants
//-----------------------------------------------------------------------------

//-----------------------------------------------------------------------------
// Data types
//-----------------------------------------------------------------------------

//-----------------------------------------------------------------------------
// Prototypes of public functions
//-----------------------------------------------------------------------------

void TaskLoRaScan(void *pvParameters);

#endif //__LORA_H
