MakeMagazinDE/Lora-Tuerueberwachung/ChickenControl/TimeLoc.h

//-----------------------------------------------------------------------------
//  TimeLoc.h
/// @file
///
/// @brief Header for the module TimeLoc.cpp
///
/// $Date:$
/// $Revision:$
/// $LastChangedBy:$
///
//-----------------------------------------------------------------------------
#ifndef __TIMELOC_H
 #define __TIMELOC_H

//-----------------------------------------------------------------------------
// Standard include files
//-----------------------------------------------------------------------------

//-----------------------------------------------------------------------------
// Project specific include files
//-----------------------------------------------------------------------------

//-----------------------------------------------------------------------------
// Definitions ,macros and constants
//-----------------------------------------------------------------------------

//-----------------------------------------------------------------------------
// Data types
//-----------------------------------------------------------------------------

//-----------------------------------------------------------------------------
// Prototypes of public functions
//-----------------------------------------------------------------------------

void GetTimeFromNTP(void);

bool IsDst(void);

void TaskUpdateUi( void *pvParameters );

void printLocalTime(void);

#endif //__TIMELOC_H
