MakeMagazinDE/Lora-Tuerueberwachung/ChickenControl/DayOfWeek.h

//-----------------------------------------------------------------------------
//  DayOfWeek.h
/// @file
///
/// @brief Header for the file DayOfWeek.cpp
///
/// @status  Draft
/// $Date:$
/// $Revision$
/// $LastChangedBy:$
//-----------------------------------------------------------------------------
#ifndef __DAYOFWEEK_H
 #define __DAYOFWEEK_H

//-----------------------------------------------------------------------------
// Standard include files
//-----------------------------------------------------------------------------

//-----------------------------------------------------------------------------
// Project specific include files
//-----------------------------------------------------------------------------

//-----------------------------------------------------------------------------
// Definitions ,macros and constants
//-----------------------------------------------------------------------------

//-----------------------------------------------------------------------------
// Data types
//-----------------------------------------------------------------------------

//-----------------------------------------------------------------------------
// Prototypes of public functions
//-----------------------------------------------------------------------------

int GetDayOfWeekForDate(int day, int month, int year);

int GetLastWeekDayInMonth(int weekDay, int month, int year);

#endif //__DAYOFWEEK_H
