MakeMagazinDE/Lora-Tuerueberwachung/ChickenControl/Utilities.cpp

//-----------------------------------------------------------------------------
//  Utilities.cpp
/// @file
///
/// @brief Contains some tool functions
///
/// $Date:$
/// $Revision:$
/// $LastChangedBy:$
///
//-----------------------------------------------------------------------------

//-----------------------------------------------------------------------------
// Standard include files
//-----------------------------------------------------------------------------
#include <Arduino.h>

//-----------------------------------------------------------------------------
// Project specific include files
//-----------------------------------------------------------------------------
#include "Utilities.h"

//-----------------------------------------------------------------------------
// Private definitions, macros and constants
//-----------------------------------------------------------------------------

//-----------------------------------------------------------------------------
// Private data types
//-----------------------------------------------------------------------------

//-----------------------------------------------------------------------------
// External references
//-----------------------------------------------------------------------------

//-----------------------------------------------------------------------------
// Global members of the module
//-----------------------------------------------------------------------------

//-----------------------------------------------------------------------------
// Prototypes of private functions
//-----------------------------------------------------------------------------

//-----------------------------------------------------------------------------
// Implementation
//-----------------------------------------------------------------------------

// utility function for digital clock display: prints leading 0
String twoDigits(int digits)
{
   if(digits < 10)
   {
      String i = '0'+String(digits);
      return i;
   }
   else
   {
      return String(digits);
   }
}
