MakeMagazinDE/Lora-Tuerueberwachung/ChickenControl/Utilities.h

//-----------------------------------------------------------------------------
//  Utilities.h
/// @file
///
/// @brief Header for the module Utilities.cpp
///
/// $Date:$
/// $Revision:$
/// $LastChangedBy:$
///
//-----------------------------------------------------------------------------
#ifndef __UTILITIES_H
 #define __UTILITIES_H

//-----------------------------------------------------------------------------
// Standard include files
//-----------------------------------------------------------------------------

//-----------------------------------------------------------------------------
// Project specific include files
//-----------------------------------------------------------------------------

//-----------------------------------------------------------------------------
// Definitions ,macros and constants
//-----------------------------------------------------------------------------

//-----------------------------------------------------------------------------
// Data types
//-----------------------------------------------------------------------------

//-----------------------------------------------------------------------------
// Prototypes of public functions
//-----------------------------------------------------------------------------

String twoDigits(int digits);

#endif //__UTILITIES_H
